HighlandersFRC/2014-electronics/README.md

2014-electronics
================

The electronics design for the 2014 robot.
