HighlandersFRC/2014-electronics/2014electronics.sch

## KiCad design 2014electronics.sch (2014-02-10)

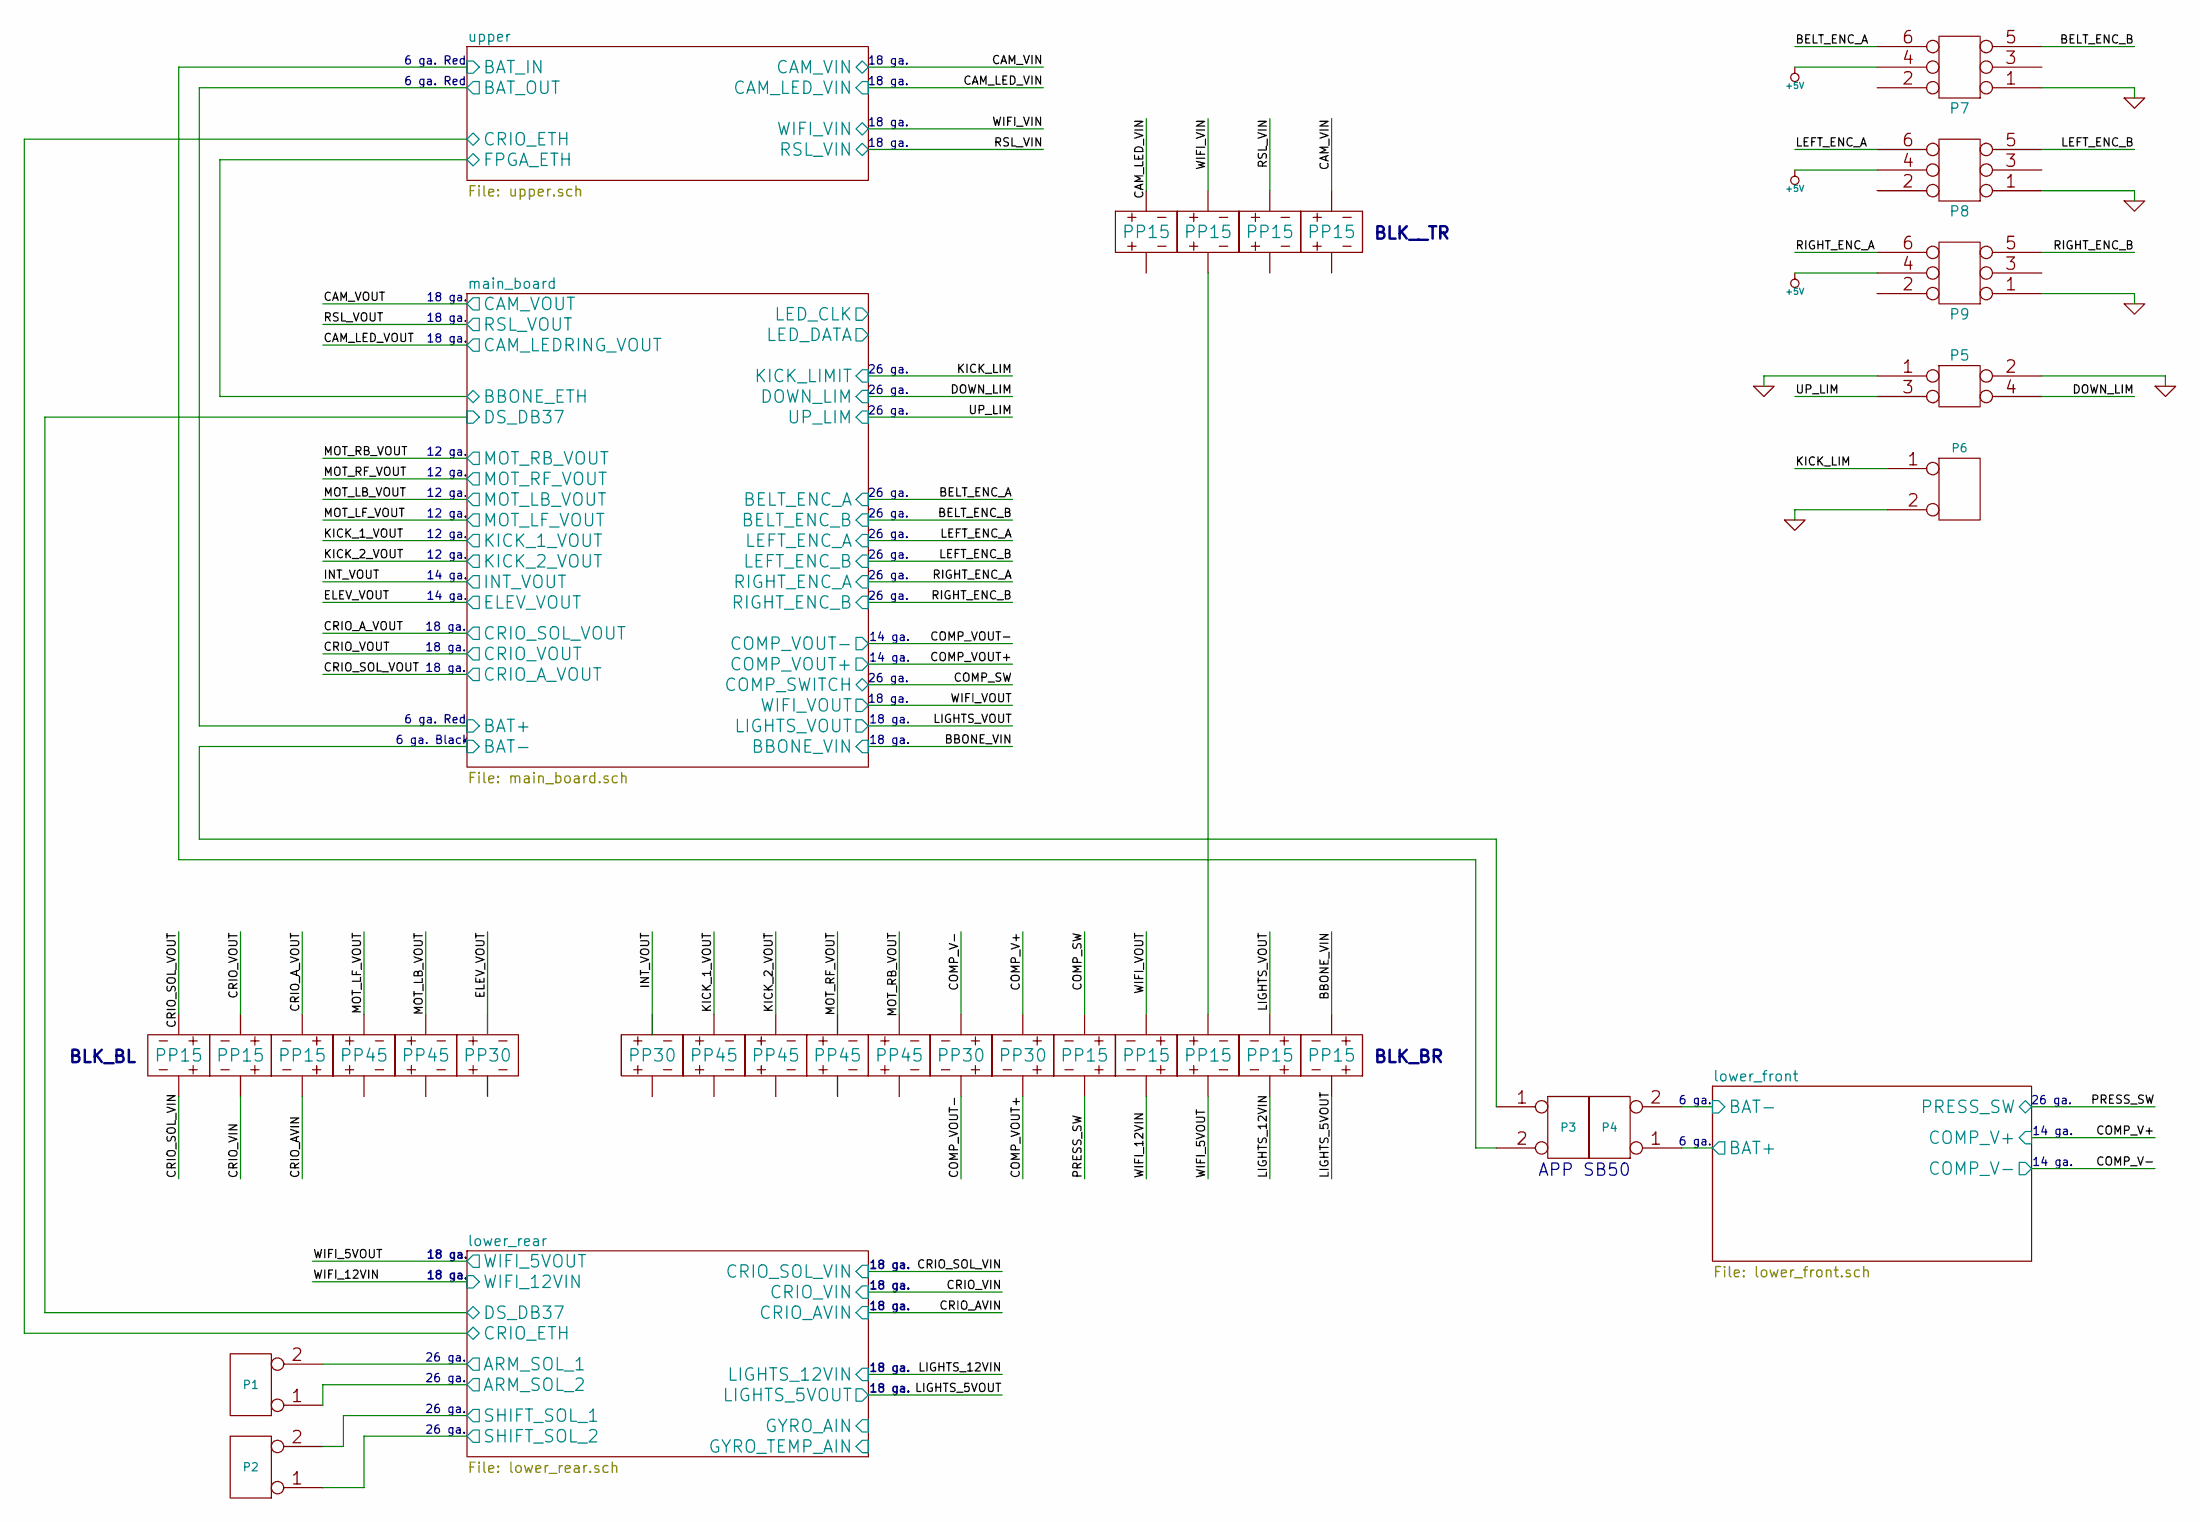
[picture p1: schematic 2014electronics.sch]

Parts:
J1, J2, J3, J4, J5, J10, J15, J16, J17, J18, J19, J22: PP15
J6, J7, J11, J12, J13, J14: PP45
J8, J9, J20, J21: PP30
P1, P2, P3, P4, P6: CONN_2
P5: CONN_2X2
P7, P8, P9: CONN_3X2

Connections:
+5V: P7.4, P8.4, P9.4
ARM_SOL_1: P1.2 (PM)
ARM_SOL_2: P1.1
BAT+: P4.1
BAT-: P3.1, P4.2 (PM)
BAT_IN: P3.2 (PM)
BBONE_VIN: J19.~
BELT_ENC_A: P7.6
BELT_ENC_B: P7.5
CAM_LED_VIN: J1.~
CAM_VIN: J10.~
COMP_SW: J22.~
COMP_V+: J21.~
COMP_V-: J20.~
COMP_VOUT+: J21.~
COMP_VOUT-: J20.~
CRIO_AVIN: J17.~
CRIO_A_VOUT: J17.~
CRIO_SOL_VIN: J15.~
CRIO_SOL_VOUT: J15.~
CRIO_VIN: J16.~
CRIO_VOUT: J16.~
DOWN_LIM: P5.4
GND: P5.1, P5.2, P6.2 (PM), P7.1, P8.1, P9.1
KICK_1_VOUT: J7.~
KICK_2_VOUT: J6.~
KICK_LIM: P6.1
LEFT_ENC_A: P8.6
LEFT_ENC_B: P8.5
LIGHTS_5VOUT: J19.~
LIGHTS_12VIN: J18.~
LIGHTS_VOUT: J18.~
MOT_LB_VOUT: J13.~
MOT_LF_VOUT: J14.~
MOT_RB_VOUT: J11.~
MOT_RF_VOUT: J12.~
unnamed: J3.~, J4.~
PRESS_SW: J22.~
RIGHT_ENC_A: P9.6
RIGHT_ENC_B: P9.5
RSL_VIN: J5.~
SHIFT_SOL_1: P2.2 (PM)
SHIFT_SOL_2: P2.1
UP_LIM: P5.3
WIFI_5VOUT: J4.~
WIFI_12VIN: J2.~
WIFI_VIN: J3.~
WIFI_VOUT: J2.~

Notes on the sheet:
6 ga. Black
APP SB50
6 ga.
6 ga. Red
18 ga.
12 ga.
14 ga.
BLK__TR
BLK_BR
BLK_BL
26 ga.
