HighlandersFRC/2014-electronics/lower_front.sch

## KiCad design lower_front.sch (2014-02-08)

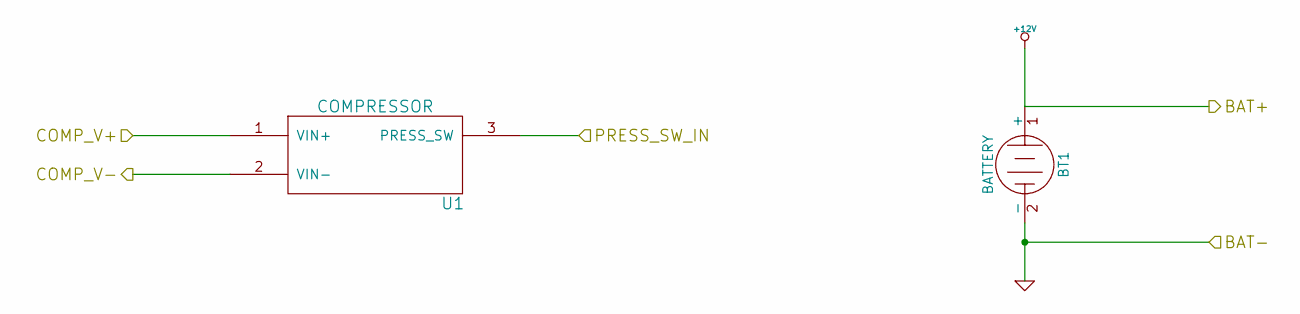
[picture p2: schematic lower_front.sch]

Parts:
BT1: BATTERY
U1: COMPRESSOR

Connections:
+12V: BT1.1 (+)
COMP_V+: U1.1 (VIN+)
COMP_V-: U1.2 (VIN-)
GND: BT1.2 (-)
PRESS_SW_IN: U1.3 (PRESS_SW)
