HighlandersFRC/2014-electronics/lower_rear.sch

## KiCad design lower_rear.sch (2014-02-08)

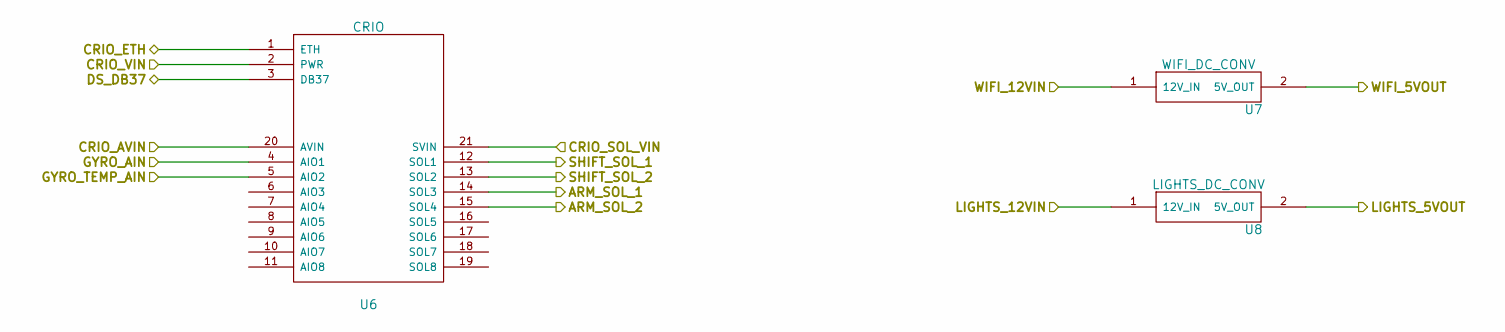
[picture p3: schematic lower_rear.sch]

Parts:
U6: CRIO
U7: WIFI_DC_CONV
U8: LIGHTS_DC_CONV

Connections:
ARM_SOL_1: U6.14 (SOL3)
ARM_SOL_2: U6.15 (SOL4)
CRIO_AVIN: U6.20 (AVIN)
CRIO_ETH: U6.1 (ETH)
CRIO_SOL_VIN: U6.21 (SVIN)
CRIO_VIN: U6.2 (PWR)
DS_DB37: U6.3 (DB37)
GYRO_AIN: U6.4 (AIO1)
GYRO_TEMP_AIN: U6.5 (AIO2)
LIGHTS_5VOUT: U8.2 (5V_OUT)
LIGHTS_12VIN: U8.1 (12V_IN)
SHIFT_SOL_1: U6.12 (SOL1)
SHIFT_SOL_2: U6.13 (SOL2)
WIFI_5VOUT: U7.2 (5V_OUT)
WIFI_12VIN: U7.1 (12V_IN)
