HighlandersFRC/2014-electronics/main_board.sch

## KiCad design main_board.sch (2014-02-08)

Schematic: main_board.sch

Parts:
U5: PD_BOARD
U9: DIGITAL_SIDECAR
U10, U11, U12, U16, U17, U18, U19: TALON
U13: JAGUAR
U14: SPIKE_RELAY
U15: FPGA

Notes on the sheet:
Note: COMP_VOUT- comes from the ground wire of the Spike relay's VIN wire.
20A
30A
Note: Make sure the Spike relay has a 20A auto reset breaker.
