HighlandersFRC/2014-electronics/upper.sch

## KiCad design upper.sch (2014-02-08)

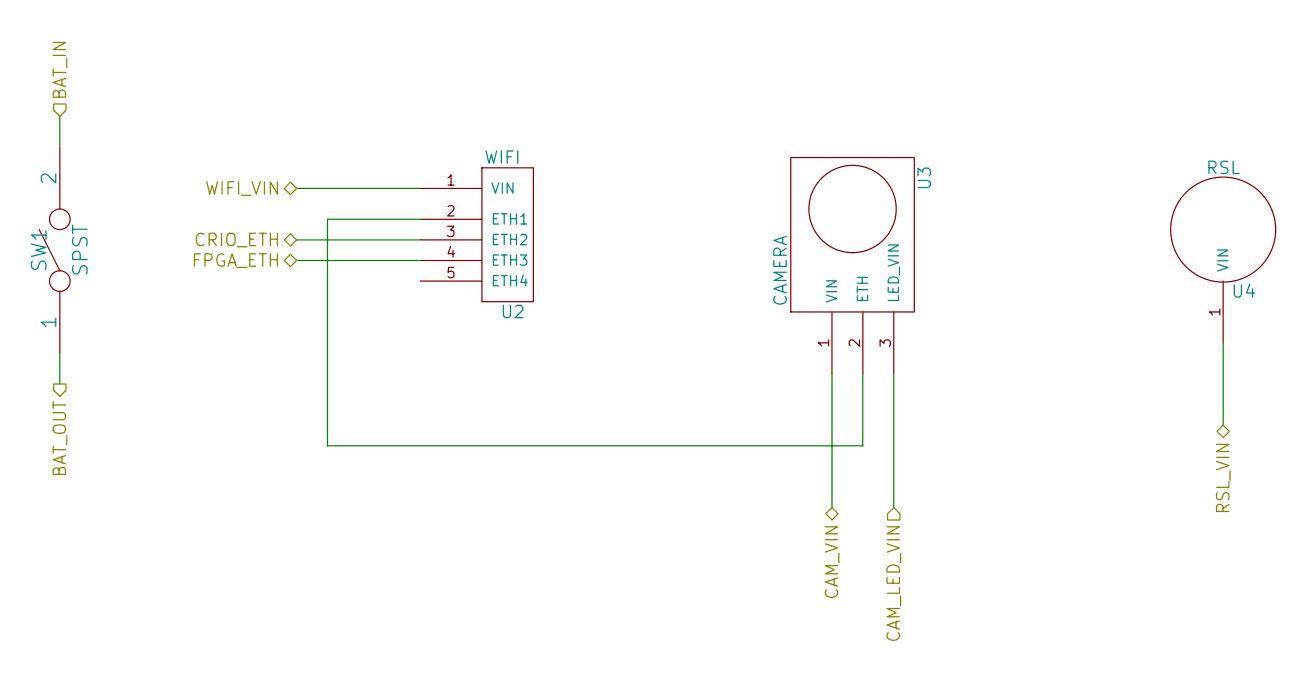
[picture p4: schematic upper.sch]

Parts:
SW1: SPST
U2: WIFI
U3: CAMERA
U4: RSL

Connections:
BAT_IN: SW1.2
BAT_OUT: SW1.1
CAM_LED_VIN: U3.3 (LED_VIN)
CAM_VIN: U3.1 (VIN)
CRIO_ETH: U2.3 (ETH2)
FPGA_ETH: U2.4 (ETH3)
unnamed: U2.2 (ETH1), U3.2 (ETH)
RSL_VIN: U4.1
WIFI_VIN: U2.1 (VIN)
