HighlandersFRC/2014-electronics/docs/wiring.xlsx

ID | From | To | Type | Gauge | Length | Connector 1 Type | Connector 2 Type | Notes
1 | PD board 40AMP | Talon K2 | R+B | 12 ga. | 18” | 0.5” bare | Ring
2 | Talon K1 | BLK_BR | R+B | 12 ga. | 24” | Ring | PP 45
3 | Talon K2 | BLK_BR | R+B | 12 ga. | 20” | Ring | PP 45
4 | PD board 40AMP | Talon K1 | R+B | 12 ga. | 24” | 0.5” bare | Ring
5 | Talon LB | BLK_BL | R+B | 12 ga. | 27” | Ring | PP 45
6 | Talon LF | BLK_BL | R+B | 12 ga. | 30” | Ring | PP 45
7 | PD board 40AMP | Talon RB | R+B | 12 ga. | 25” | 0.5” bare | Ring
8 | PD board 40AMP | Talon LB | R+B | 12 ga. | 25” | 0.5” bare | Ring
9 | PD board 40AMP | Talon LF | R+B | 12 ga. | 27” | 0.5” bare | Ring
10 | Talon RB | BLK_BR | R+B | 12 ga. | 30” | Ring | PP 45
11 | Talon RF | BLK_BR | R+B | 12 ga. | 27” | Ring | PP 45
12 | PD board 40AMP | Talon RF | R+B | 12 ga. | 30” | 0.5” bare | Ring
13 | PD board 30AMP | Spike V+ | R | 14 ga. | 10” | 0.5” bare | Female Spade
14 | PD board 30AMP | Compressor – splice | B | 14 ga. | 10” | 0.5” bare | 0.5” bare
15 | Elevator Motor | BLK_BL | R+B | 14 ga. | 12” | PP 30 | PP 30
16 | Spike M+ | BLK_BR | R | 14 ga. | 18” | Female Spade | PP 30 | Compressor
17 | Jag ELEV | BLK_BL | R+B | 14 ga. | 27” | Ring | PP 30
18 | Compressor – splice | BLK_BR | B | 14 ga. | 18” | 0.5” bare | PP 30
19 | PD board 30AMP | Jag ELEV | R+B | 14 ga. | 20” | 0.5” bare | Ring
20 | Talon INT | BLK_BL | R+B | 14 ga. | 35” | Ring | PP 30
21 | PD board 30AMP | Talon INT | R+B | 14 ga. | 35” | 0.5” bare | Ring
22 | BLK_BR | Compressor pwr | R+B | 14 ga. | 42” | PP 30 | 0.5” bare
23 | Compressor – splice | Spike V- | B | 14 ga. | 6” | 0.5” bare | Female Spade
24 | Intake motor | BLK_BR | R+B | 14 ga. | 60” | PP 30 | PP 30
25 | BLK_TR | WIFI_VIN | R+B | 18 ga. | 10” | PP 15 | 0.5” bare
26 | BLK_TR | CAM_LED_VIN | R+B | 18 ga. | 18” | PP 15 | 0.5” bare | BLK_TR is at top of right tower.
27 | BLK_TR | CAM_VIN | R+B | 18 ga. | 18” | PP 15 | 0.5” bare
28 | PD board 12v | BLK_BR | R+B | 18 ga. | 18” | WAGO 734-102 | PP 15
29 | DC converter WIFI 5v | BLK_BR | R+B | 18 ga. | 20” | 0.5” bare | PP 15
30 | DC converter WIFI 12v | BLK_BR | R+B | 18 ga. | 20” | 0.5” bare | PP 15
31 | cRIO pwr | BLK_BL | R+B | 18 ga. | 20” | 0.5” bare | PP 15
32 | cRIO solenoid pwr | BLK_BL | R+B | 18 ga. | 20” | WAGO 734-102 | PP 15
33 | cRIO analog pwr | BLK_BL | R+B | 18 ga. | 20” | WAGO 734-102 | PP 15
34 | DC converter LIGHTS 5v | BLK_BR | R+B | 18 ga. | 25” | 0.5” bare | PP 15
35 | DC converter LIGHTS 12v | BLK_BR | R+B | 18 ga. | 25” | 0.5” bare | PP 15
36 | PD board 24v | BLK_BL | R+B | 18 ga. | 25” | 0.5” bare | PP 15 | cRIO pwr
37 | PD board 24v | BLK_BL | R+B | 18 ga. | 25” | 0.5” bare | PP 15 | cRIO Solenoid pwr
38 | PD BOARD 30AMP | BLK_BL | R+B | 18 ga. | 28” | 0.5” bare | PP 15 | cRIO analog pwr
39 | PD board 30AMP | BLK_BR | R+B | 18 ga. | 28” | 0.5” bare | PP 15 | Lights
40 | PD BOARD 5v | BLK_TR | R+B | 18 ga. | 35” | 0.5” bare | PP 15 | CAM_VOUT
41 | Digital Sidecar RSL | BLK_TR | R+B | 18 ga. | 32” | 0.5” bare | PP 15
42 | PD BOARD 30AMP | BLK_TR | R+B | 18 ga. | 32” | 0.5” bare | PP 15 | CAM_LEDRING_VOUT
43 | Bbone pwr | BLK_BR | R+B | 18 ga. | 32” | 0.5” bare | PP 15
44 | BLK_BR | BLK_TR | R+B | 18 ga. | 40” | PP 15 | PP 15 | WIFI 5v pwr
45 | BLK_TR | RSL_VIN | R+B | 18 ga. | 6” | PP 15 | 0.5” bare
46 | PD board 30AMP | DS pwr | R+B | 18 ga. | 8” | 0.5” bare | WAGO 734-102
47 | P5 | Lower Limit switch | R+B | 24 ga. | 20” | Molex 2x2 | N/A | Same Microfit Connector as previous.
48 | P5 | Upper Limit switch | R+B | 24 ga. | 42” | Molex 2x2 | N/A
49 | DS relay | Spike | PWM | 26 ga. | 12” | Female PWM | Male PWM
50 | DS GPIO | P9 | PWM | 26 ga. | 18” | Female PWM | Molex Microfit 2x3 | Right encoder A
51 | DS GPIO | P9 | PWM | 26 ga. | 18” | Female PWM | Molex Microfit 2x3 | Same Microfit Connector as previous. Right encoder B
52 | Jag Fwd limit | P5 | R+B | 26 ga. | 18” | 2x1 0.1” header | Molex Microfit 2x2 | Top elevator limit
53 | Jag Rev limit | P5 | R+B | 26 ga. | 18” | 2x1 0.1” header | Molex Microfit 2x2 | Same Microfit Connector as previous. Bottom elevator limit
54 | DS PWM | Talon K1 | PWM | 26 ga. | 20” | Female PWM | Male PWM
55 | DS PWM | Talon K2 | PWM | 26 ga. | 20” | Female PWM | Male PWM
56 | DS PWM | Talon RB | PWM | 26 ga. | 28” | Female PWM | Male PWM
57 | DS PWM | Talon RF | PWM | 26 ga. | 28” | Female PWM | Male PWM
58 | DS PWM | Talon LB | PWM | 26 ga. | 28” | Female PWM | Male PWM
59 | DS PWM | Talon LF | PWM | 26 ga. | 28” | Female PWM | Male PWM
60 | DS PWM | Jag ELEV | PWM | 26 ga. | 28” | Female PWM | Male PWM
61 | DS GPIO | P8 | PWM | 26 ga. | 32” | Female PWM | Molex Microfit 2x3 | Left encoder A. Lower left of main board.
62 | DS GPIO | P8 | PWM | 26 ga. | 32” | Female PWM | Molex Microfit 2x3 | Same Microfit Connector as previous. Left encoder B
63 | DS GPIO | P7 | PWM | 26 ga. | 40” | Female PWM | Molex Microfit 2x3 | Belt encoder A
64 | DS GPIO | P7 | PWM | 26 ga. | 40” | Female PWM | Molex Microfit 2x3 | Same Microfit Connector as previous. Belt encoder B
65 | DS GPIO | P6 | PWM | 26 ga. | 40” | Female PWM | Molex Microfit 1x2
66 | BLK_BR | Compressor pressure switch | R+B | 26 ga. | 42” | PP 15 | 0.5” bare
67 | DS PWM | Talon INT | PWM | 26 ga. | 46” | Female PWM | Male PWM
68 | DS GPIO | BLK_BR | R+B | 26 ga. | 8” | Female PWM | PP 15 | Compressor pressure switch
69 | P3 | PD board V- | B | 6 ga. | 40” | APP SB 50 | Ring | Battery
70 | Main Breaker | PD board V+ | R | 6 ga. | 60” | Ring | Ring
71 | P3 | Main Breaker | R | 6 ga. | 80” | APP SB 50 | Ring | Battery
72 | WIFI | Camera | Ethernet | N/A | 18” | N/A | N/A
73 | Digital Sidecar DB37 | cRIO digital DB37 | DB37 | N/A | 24” | DB37 | DB37
74 | WIFI | FPGA_ETH | Ethernet | N/A | 6' | N/A | N/A
75 | WIFI | cRIO_ETH | Ethernet | N/A | 6' | N/A | N/A
