HighlandersFRC/2014-electronics/(commit log)

2014-02-06 Initial commit of 2014 electronics boards
    [2014electronics.sch, lower_front.sch, lower_rear.sch, main_board.sch, upper.sch]
2014-02-06 Udpates to main board and start of connector spec.
    [2014electronics.sch, lower_front.sch, main_board.sch, upper.sch]
2014-02-06 Cleaned up main board schematic a little more
    [2014electronics.sch, main_board.sch]
2014-02-07 Added more connector blocks and wire sizes
    [2014electronics.sch, lower_front.sch, lower_rear.sch, main_board.sch, upper.sch]
2014-02-07 Added more wire size annotations. Added labels for motor block.
    [2014electronics.sch]
2014-02-08 Modified layout of main board components. Replaced more wires with net labels.
    [2014electronics.sch, lower_front.sch, lower_rear.sch, main_board.sch, upper.sch]
2014-02-10 Minor revisions to wiring
    [2014electronics.sch]
2014-02-15 Added wiring BOM.
    [wiring.xlsx]
